bmakersspace/LRA---Airbrake-Redundancy-Board/Airbrake Redundancy Board.kicad_sch

## KiCad design Airbrake Redundancy Board.kicad_sch (2026-04-09)

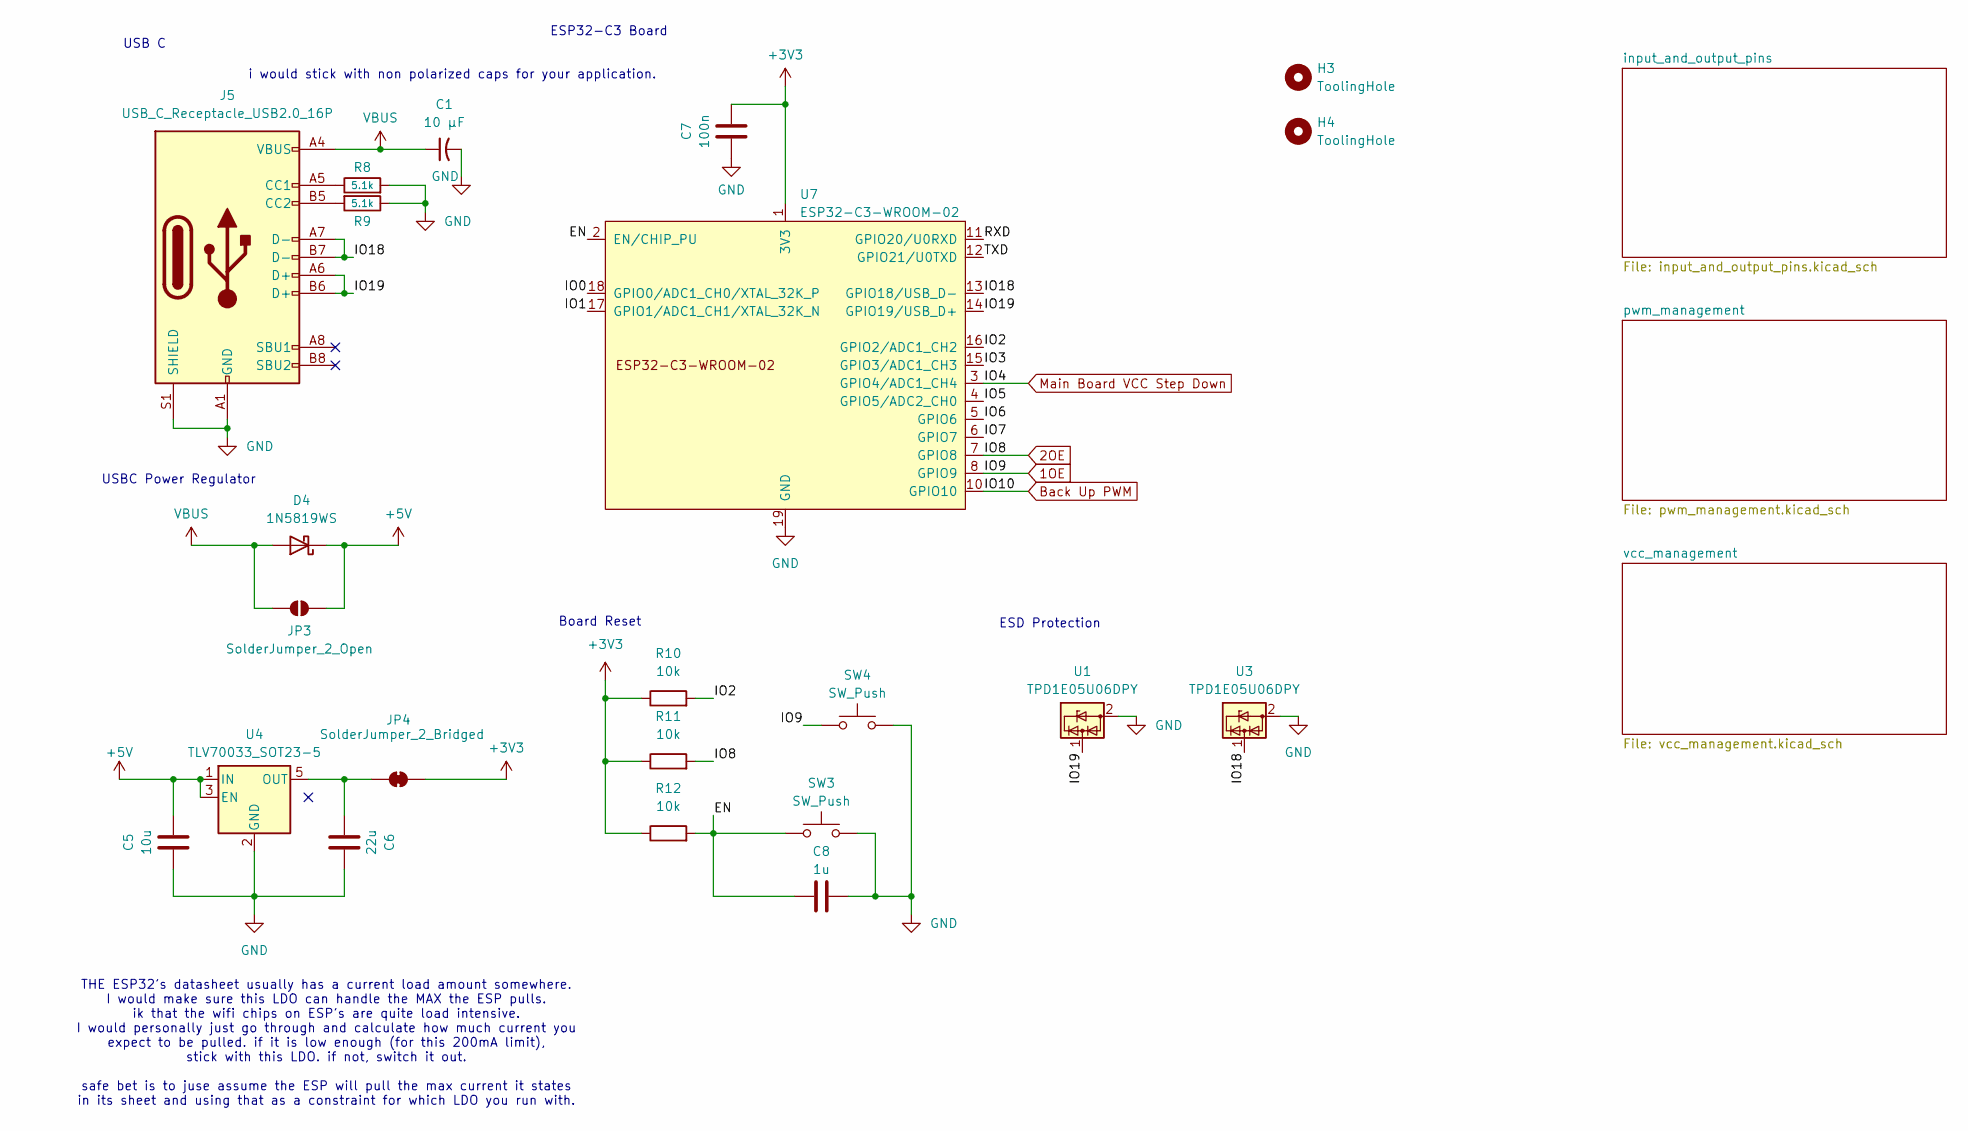
[picture p1: schematic Airbrake Redundancy Board.kicad_sch]

Parts:
C1: 10 μF
C5: 10u; C_0805_2012Metric; LCSC Part # C15850
C6: 22u; C_0603_1608Metric; LCSC Part # C59461
C7: 100n; C_0402_1005Metric; LCSC Part # C1525
C8: 1u; C_0402_1005Metric; LCSC Part # C52923
D4: 1N5819WS; D_SOD-323; LCSC Part # C191023
H3, H4: ToolingHole; Tooling_Hole
J5: USB_C_Receptacle_USB2.0_16P; USB_C_Receptacle_XKB_U262-16XN-4BVC11; LCSC Part # C2988369
JP3: SolderJumper_2_Open; SolderJumper-2_P1.3mm_Open_RoundedPad1.0x1.5mm
JP4: SolderJumper_2_Bridged; SolderJumper-2_P1.3mm_Bridged_RoundedPad1.0x1.5mm
R8, R9: 5.1k; R_0402_1005Metric; LCSC C25905
R10, R11, R12: 10k; R_0402_1005Metric; LCSC Part # C25744
SW3, SW4: SW_Push; SW_SPST_PTS810; LCSC Part # C115360
U1, U3: TPD1E05U06DPY; Texas_DPY0002A_0.6x1mm_P0.65mm
U4: TLV70033_SOT23-5; SOT-23-5
U7: ESP32-C3-WROOM-02; LCSC Part # C2934560

Connections:
1OE: SW4.1, U7.8 (GPIO9)
2OE: R11.2, U7.7 (GPIO8)
+3V3: C7.2, JP4.2 (B), R10.1, R11.1, R12.1, U7.1 (3V3)
+5V: C5.2, D4.1 (K), JP3.2 (B), U4.1 (IN), U4.3 (EN)
Back Up PWM: U7.10 (GPIO10)
EN: C8.1, R12.2, SW3.1, U7.2 (EN/CHIP_PU)
GND: C1.2, C5.1, C6.2, C7.1, C8.2, J5.A1 (GND), J5.A12 (GND), J5.B1 (GND), J5.B12 (GND), J5.S1 (SHIELD), R8.2, R9.1, SW3.2, SW4.2, U1.2 (GND), U3.2 (GND), U4.2 (GND), U7.9 (GND), U7.19 (GND)
IO0: U7.18 (GPIO0/ADC1_CH0/XTAL_32K_P)
IO1: U7.17 (GPIO1/ADC1_CH1/XTAL_32K_N)
IO2: R10.2, U7.16 (GPIO2/ADC1_CH2)
IO3: U7.15 (GPIO3/ADC1_CH3)
IO5: U7.4 (GPIO5/ADC2_CH0)
IO6: U7.5 (GPIO6)
IO7: U7.6 (GPIO7)
IO18: J5.A7 (D-), J5.B7 (D-), U3.1 (I/O), U7.13 (GPIO18/USB_D-)
IO19: J5.A6 (D+), J5.B6 (D+), U1.1 (I/O), U7.14 (GPIO19/USB_D+)
Main Board VCC Step Down: U7.3 (GPIO4/ADC1_CH4)
unnamed: C6.1, JP4.1 (A), U4.5 (OUT)
unnamed: J5.A5 (CC1), R8.1
unnamed: J5.B5 (CC2), R9.2
RXD: U7.11 (GPIO20/U0RXD)
TXD: U7.12 (GPIO21/U0TXD)
VBUS: C1.1, D4.2 (A), J5.A4 (VBUS), J5.A9 (VBUS), J5.B4 (VBUS), J5.B9 (VBUS), JP3.1 (A)

Notes on the sheet:
USBC Power Regulator
USB C
ESP32-C3 Board
ESD Protection
Board Reset
i would stick with non polarized caps for your application.
THE ESP32's datasheet usually has a current load amount somewhere. I would make sure this LDO can handle the MAX the ESP pulls. ik that the wifi chips on ESP's are quite load intensive. I would personally just go through and calculate how much current you expect to be pulled. if it is low enough (f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
