bmakersspace/LRA---Airbrake-Redundancy-Board/input_and_output_pins.kicad_sch

## KiCad design input_and_output_pins.kicad_sch (2026-04-07)

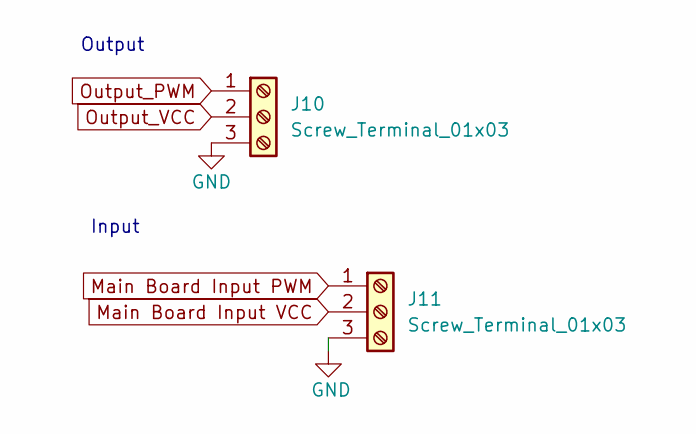
[picture p2: schematic input_and_output_pins.kicad_sch]

Parts:
J10, J11: Screw_Terminal_01x03

Connections:
GND: J10.3, J11.3
Main Board Input PWM: J11.1
Main Board Input VCC: J11.2
Output_PWM: J10.1
Output_VCC: J10.2

Notes on the sheet:
Input
Output
