bmakersspace/LRA---Airbrake-Redundancy-Board/pwm_management.kicad_sch

## KiCad design pwm_management.kicad_sch (2026-04-09)

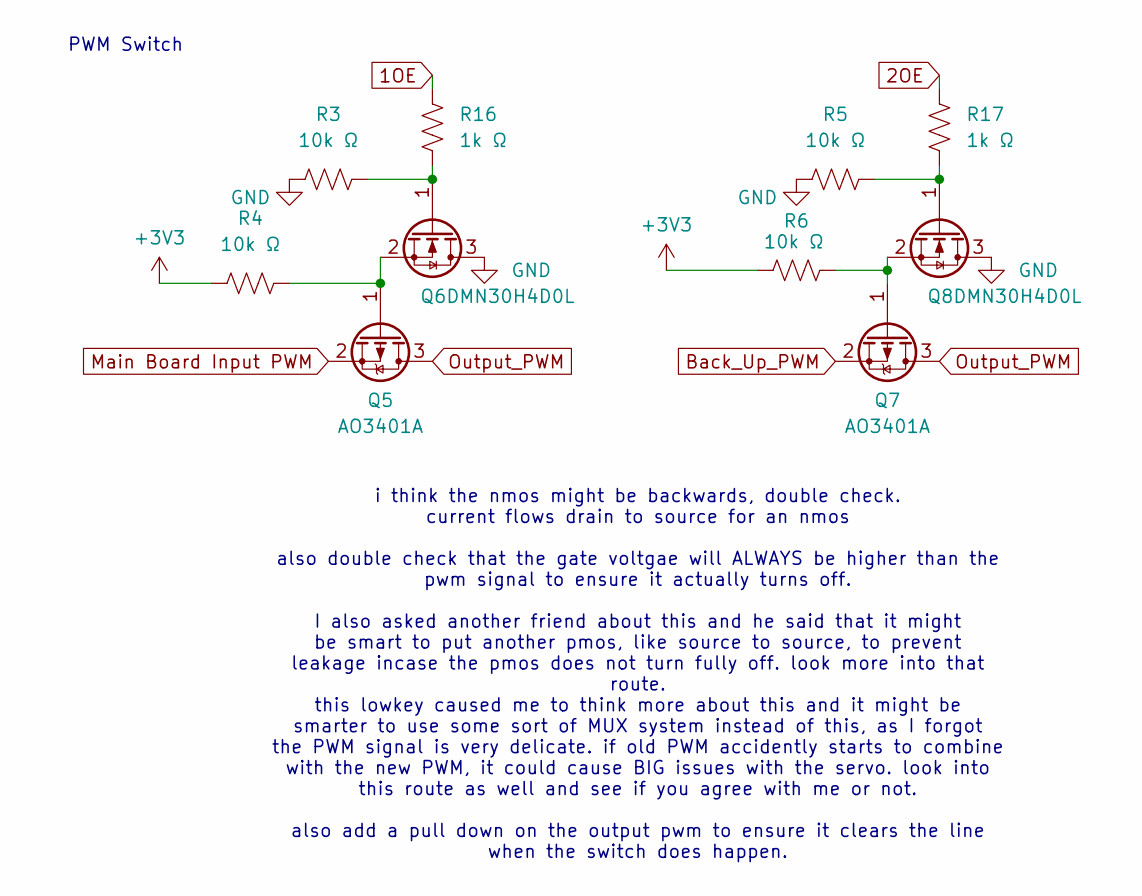
[picture p3: schematic pwm_management.kicad_sch]

Parts:
Q5, Q7: AO3401A; SOT-23
Q6, Q8: DMN30H4D0L; SOT-23
R3, R4, R5, R6: 10k Ω
R16, R17: 1k Ω

Connections:
1OE: R16.2
2OE: R17.2
+3V3: R4.1, R6.1
Back_Up_PWM: Q7.2 (S)
GND: Q6.3 (D), Q8.3 (D), R3.1, R5.1
Main Board Input PWM: Q5.2 (S)
unnamed: Q5.1 (G), Q6.2 (S), R4.2
unnamed: Q6.1 (G), R3.2, R16.1
unnamed: Q7.1 (G), Q8.2 (S), R6.2
unnamed: Q8.1 (G), R5.2, R17.1
Output_PWM: Q5.3 (D), Q7.3 (D)

Notes on the sheet:
PWM Switch
i think the nmos might be backwards, double check. current flows drain to source for an nmos also double check that the gate voltgae will ALWAYS be higher than the pwm signal to ensure it actually turns off. I also asked another friend about this and he said that it might be smart to put another pm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
