bmakersspace/LRA---Airbrake-Redundancy-Board/vcc_management.kicad_sch

## KiCad design vcc_management.kicad_sch (2026-04-09)

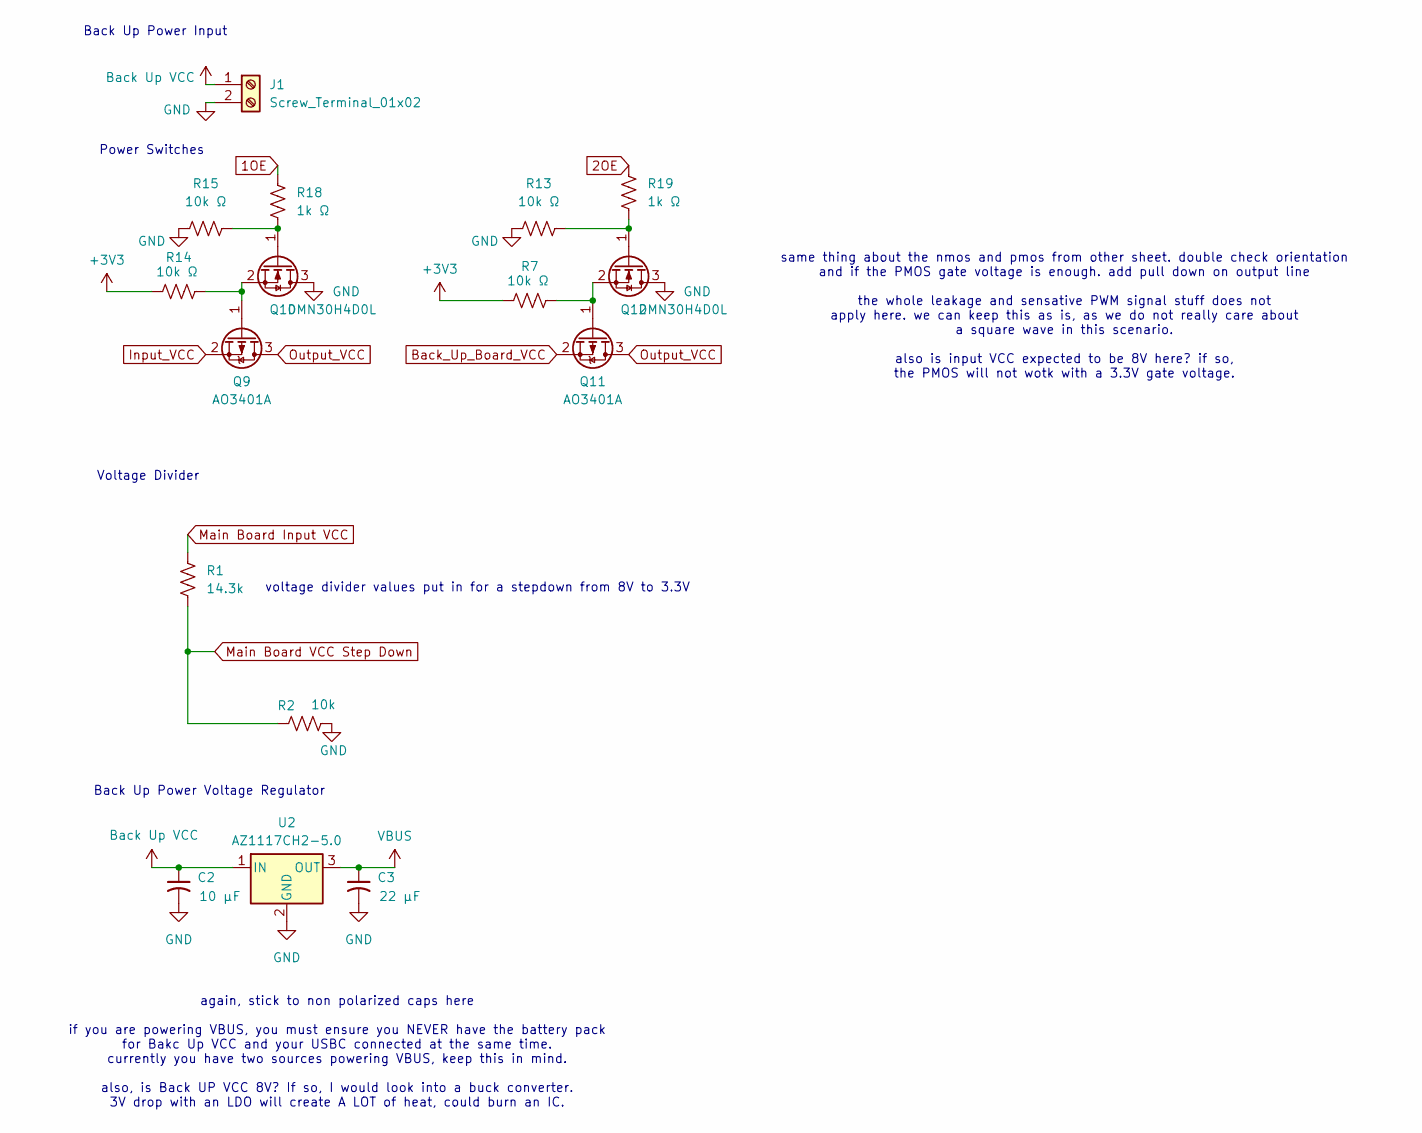
[picture p4: schematic vcc_management.kicad_sch]

Parts:
C2: 10 µF
C3: 22 µF
J1: Screw_Terminal_01x02
Q9, Q11: AO3401A; SOT-23
Q10, Q12: DMN30H4D0L; SOT-23
R1: 14.3k
R2: 10k
R7, R13, R14, R15: 10k Ω
R18, R19: 1k Ω
U2: AZ1117CH2-5.0; SOT-223-3_TabPin2

Connections:
1OE: R18.2
2OE: R19.2
+3V3: R7.1, R14.1
Back Up VCC: C2.1, J1.1, U2.1 (IN)
Back_Up_Board_VCC: Q11.2 (S)
GND: C2.2, C3.2, J1.2, Q10.3 (D), Q12.3 (D), R2.2, R13.1, R15.1, U2.2 (GND)
Input_VCC: Q9.2 (S)
Main Board Input VCC: R1.1
Main Board VCC Step Down: R1.2, R2.1
unnamed: Q10.1 (G), R15.2, R18.1
unnamed: Q9.1 (G), Q10.2 (S), R14.2
unnamed: Q11.1 (G), Q12.2 (S), R7.2
unnamed: Q12.1 (G), R13.2, R19.1
Output_VCC: Q9.3 (D), Q11.3 (D)
VBUS: C3.1, U2.3 (OUT)

Notes on the sheet:
Back Up Power Input
Voltage Divider
Power Switches
again, stick to non polarized caps here if you are powering VBUS, you must ensure you NEVER have the battery pack for Bakc Up VCC and your USBC connected at the same time. currently you have two sources powering VBUS, keep this in mind. also, is Back UP VCC 8V? If so, I would look into a buck conve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
same thing about the nmos and pmos from other sheet. double check orientation and if the PMOS gate voltage is enough. add pull down on output line the whole leakage and sensative PWM signal stuff does not apply here. we can keep this as is, as we do not really care about a square wave in this scena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
Back Up Power Voltage Regulator
voltage divider values put in for a stepdown from 8V to 3.3V
