bmakersspace/LRA---Airbrake-Redundancy-Board/(commit log)

2026-04-07 first schematic review
    [Airbrake Redundancy Board.kicad_sch, input_and_output_pins.kicad_sch, pwm_management.kicad_sch, vcc_management.kicad_sch]
2026-04-07 Add files via upload
    Revisions V2
    [Airbrake Redundancy Board.kicad_sch, input_and_output_pins.kicad_sch, pwm_management.kicad_sch, vcc_management.kicad_sch]
2026-04-09 second review
    [Airbrake Redundancy Board.kicad_sch, pwm_management.kicad_sch, vcc_management.kicad_sch]
